Spadeyache/RoboCupJunior_RescueLine/README.md

/CanMV... for k230d zero development

/k230dev-yolo...enviroment to train a yolov8n model and convert to a .kmodel for k230

/teensydev... teensy4.1 developments

/xiaoesp32dev...all developments for xiao

/Electronics... all electronics development - We use EasyEDA as our main ecad software
