Spadeyache/RoboCupJunior_RescueLine/(list of files, drawings)

Other design files:
Electronics/archiveKicad/ProPrj_Final Main_2026-01-12.epro
Electronics/easyEDA/1-12.eprj
Electronics/easyEDA/Final Main.eprj
Electronics/easyEDA/powermanagmen.eprj
Electronics/easyEDA/XIAO Board.eprj
Electronics/Main.eprj
Electronics/ProPrj_Final Main_2026-01-12.epro
Electronics/XIAO ESP32C3 Adapter board copy.eprj
