Spadeyache/RoboCupJunior_RescueLine/Electronics/archiveKicad/main/main.kicad_pcb

## KiCad design Electronics/archiveKicad/main/main.kicad_pcb (2026-01-02, an earlier design)

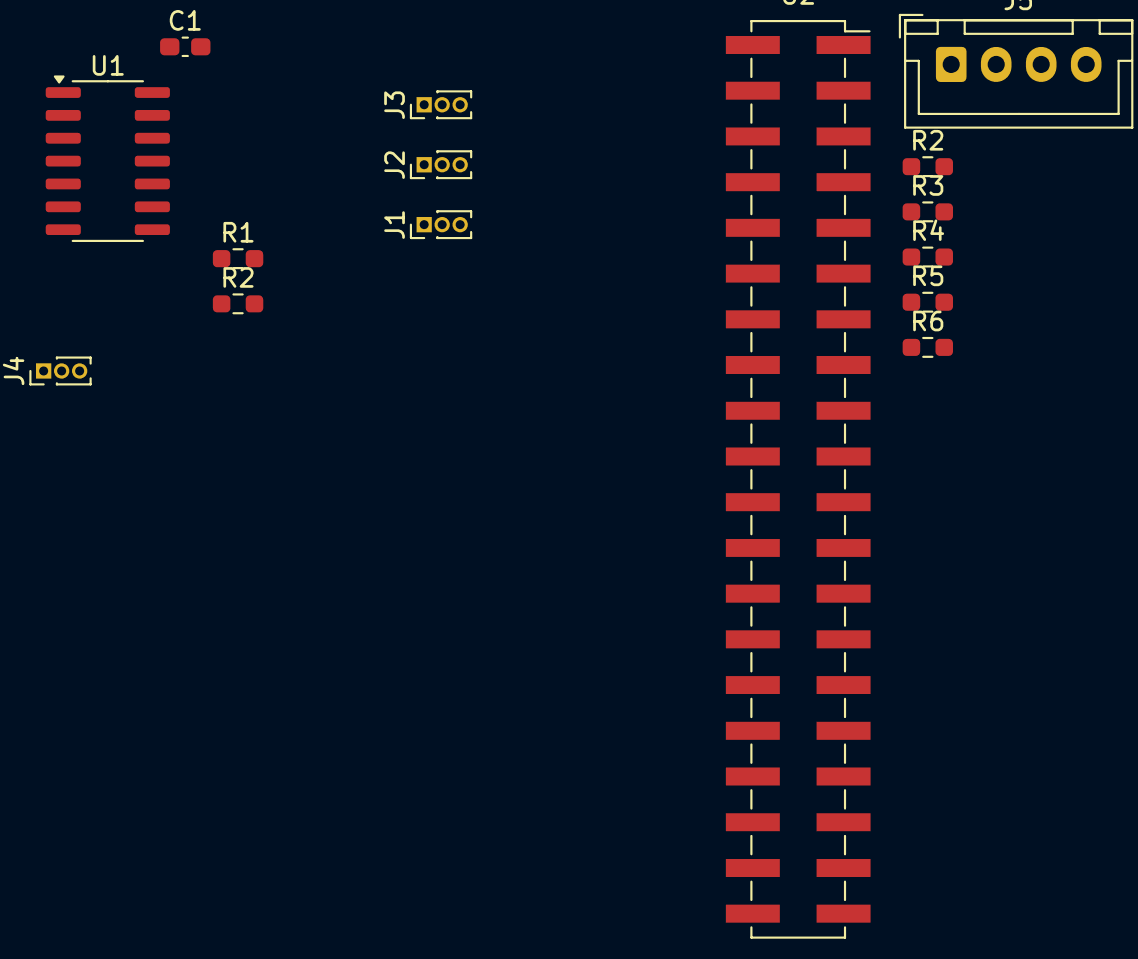
[picture p2: board main.kicad_pcb from above]

Board: 2 copper layers, 15 parts (0 on the bottom side), 8 nets, no tracks yet.

Parts:
C1: 0.1uF; C_0603_1608Metric_Pad1.08x0.95mm_HandSolder
J1: STS3032; PinHeader_1x03_P1.00mm_Vertical
J2: KRS3301; PinHeader_1x03_P1.00mm_Vertical
J3: HS45HB-0; PinHeader_1x03_P1.00mm_Vertical
J4: HS45HB-1; PinHeader_1x03_P1.00mm_Vertical
J5: IMU MPU6050; JST_XH_B4B-XH-A_1x04_P2.50mm_Vertical
R1, R2: 10k; R_0603_1608Metric_Pad0.98x0.95mm_HandSolder
R2#2, R3, R4, R5, R6: 10k?; R_0603_1608Metric_Pad0.98x0.95mm_HandSolder
U1: 74LS126; SOIC-14_3.9x8.7mm_P1.27mm
U2: K230D; PinSocket_2x20_P2.54mm_Vertical_SMD

Connections:
+5V: C1.2, J3.1, J4.1, U1.4, U1.10, U1.13, U1.14 (VCC)
+6.6V: J1.1, J2.1
GND: C1.1, J1.3, J2.3, J3.3, J4.3, J5.1, R1.1, U1.7 (GND)
HS45HB-0 signal: J3.2, U1.8
HS45HB-1 signal: J4.2, U1.11
KRS3301 signal: J2.2, U1.6
STS3032 signal: J1.2, U1.3
Teensy 2?: R1.2, U1.1
