Spadeyache/RoboCupJunior_RescueLine/Electronics/archiveKicad/Main (2).kicad_pcb

## KiCad design Electronics/archiveKicad/Main (2).kicad_pcb (2025-11-23, an earlier design)

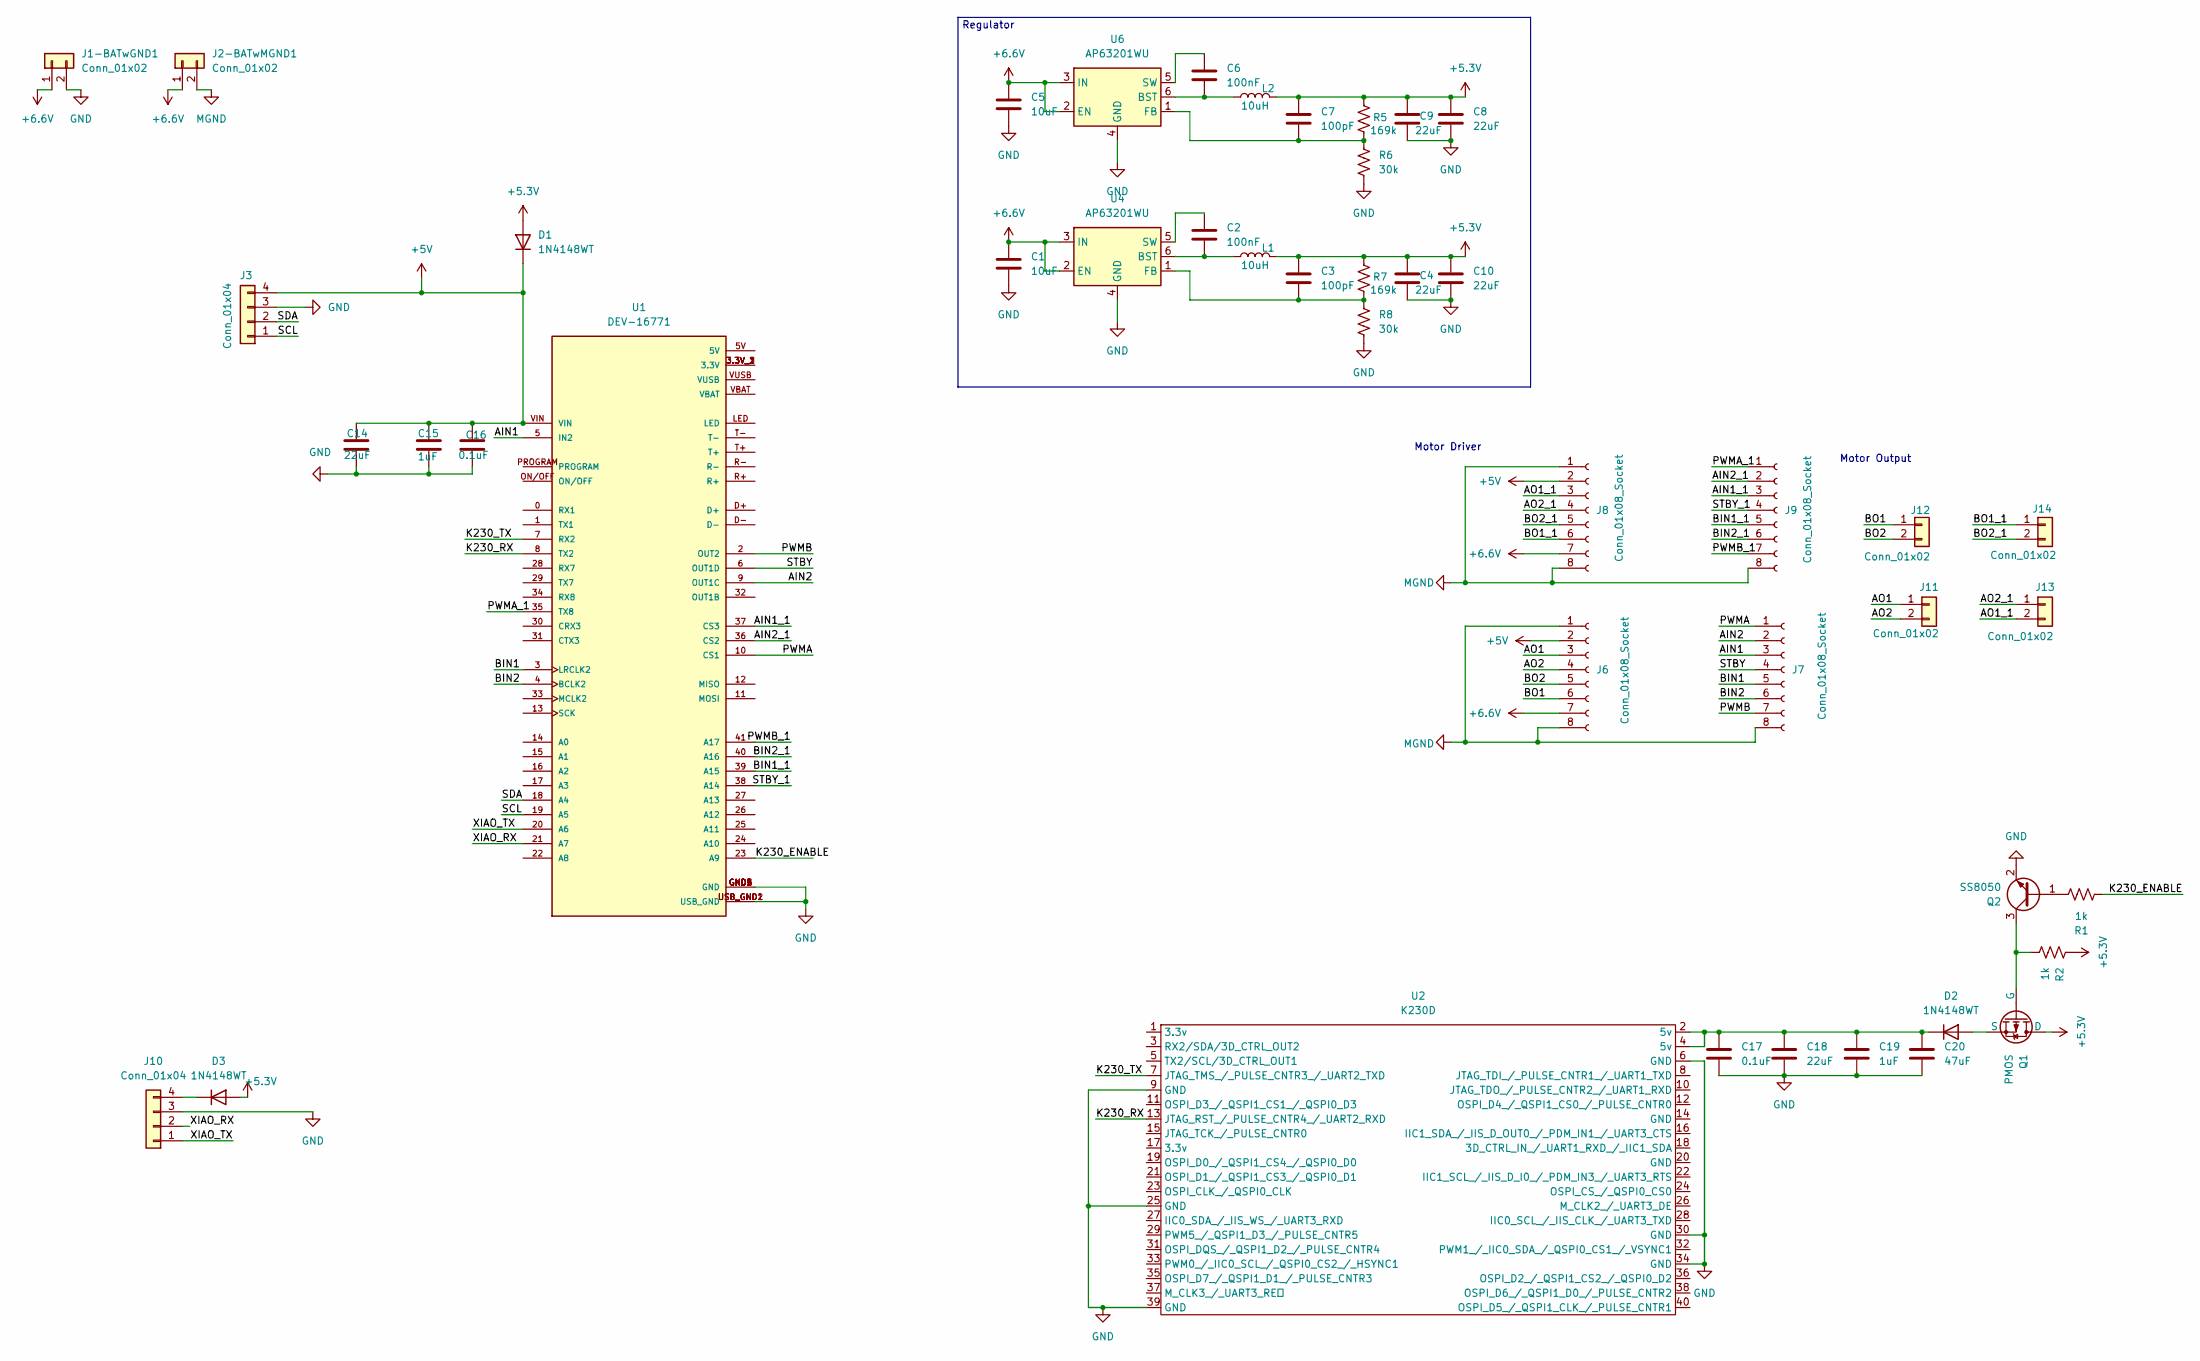
[picture p3: schematic Main (2).kicad_sch]

Parts:
C1, C5: 10uF; C_0603_1608Metric
C2, C6: 100nF; C_0603_1608Metric
C3, C7: 100pF; C_0603_1608Metric
C4, C8, C9, C10, C14, C18: 22uF; C_0603_1608Metric
C15, C19: 1uF; C_0603_1608Metric
C16, C17: 0.1uF; C_0603_1608Metric
C20: 47uF; C_0603_1608Metric
D1, D2, D3: 1N4148WT; D_SOD-523
J1-BATwGND1, J2-BATwMGND1, J11, J12, J13, J14: Conn_01x02; TE_440054-2_1x02_P2.00mm_Vertical
J3, J10: Conn_01x04; JST_XH_B4B-XH-A_1x04_P2.50mm_Vertical
J6, J7, J8, J9: Conn_01x08_Socket; PinHeader_1x08_P2.54mm_Vertical
L1, L2: 10uH; L_0603_1608Metric
Q1: PMOS; SOT-23
Q2: SS8050; SOT-23
R1, R2: 1k; R_0603_1608Metric
R5, R7: 169k; R_0603_1608Metric
R6, R8: 30k; R_0603_1608Metric
U1: DEV-16771; Teensy4.1; PARTREV 4.1
U2: K230D; PinSocket_2x20_P2.54mm_Vertical_SMD
U4, U6: AP63201WU; TSOT-23-6

Connections:
+5.3V: C3.1, C4.1, C7.1, C8.1, C9.1, C10.1, D1.2 (A), D3.2 (A), L1.2, L2.2, Q1.1 (D), R2.1, R5.1, R7.1; also elsewhere on the board
+5V: C14.1, C15.1, C16.1, D1.1 (K), J3.4, J6.2, J8.2, U1.VIN
+6.6V: C1.1, C5.1, J1-BATwGND1.1, J2-BATwMGND1.1, J6.7, J8.7, U4.2 (EN), U4.3 (IN), U6.2 (EN), U6.3 (IN); also elsewhere on the board
/AIN1: J7.3, U1.5 (IN2)
/AIN1_1: J9.3, U1.37 (CS3)
/AIN2: J7.2, U1.9 (OUT1C)
/AIN2_1: J9.2, U1.36 (CS2)
/AO1: J6.3, J11.1
/AO1_1: J8.3, J13.2
/AO2: J6.4, J11.2
/AO2_1: J8.4, J13.1
/BIN1: J7.5, U1.3 (LRCLK2)
/BIN1_1: J9.5, U1.39 (A15)
/BIN2: J7.6, U1.4 (BCLK2)
/BIN2_1: J9.6, U1.40 (A16)
/BO1: J6.6, J12.1
/BO1_1: J8.6, J14.1
/BO2: J6.5, J12.2
/BO2_1: J8.5, J14.2
/K230_ENABLE: R1.1, U1.23 (A9)
/K230_RX: U1.8 (TX2), U2.13 (JTAG_RST_/_PULSE_CNTR4_/_UART2_RXD)
/K230_TX: U1.7 (RX2), U2.7 (JTAG_TMS_/_PULSE_CNTR3_/_UART2_TXD)
/PWMA: J7.1, U1.10 (CS1)
/PWMA_1: J9.1, U1.35 (TX8)
/PWMB: J7.7, U1.2 (OUT2)
/PWMB_1: J9.7, U1.41 (A17)
/SCL: J3.1, U1.19 (A5)
/SDA: J3.2, U1.18 (A4)
/STBY: J7.4, U1.6 (OUT1D)
/STBY_1: J9.4, U1.38 (A14)
/XIAO_RX: J10.2, U1.21 (A7)
/XIAO_TX: J10.1, U1.20 (A6)
GND: C1.2, C4.2, C5.2, C8.2, C9.2, C10.2, C14.2, C15.2, C16.2, C17.2, C18.2, C19.2, C20.2, J1-BATwGND1.2, J3.3, J10.3, Q2.2 (E), R6.2, R8.2, U1.GND1 (GND), U1.GND2 (GND), U1.GND3 (GND), U1.GND4 (GND), U1.GND5 (GND), U1.USB_GND1 (USB_GND), U1.USB_GND2 (USB_GND), U2.6 (GND), U2.9 (GND), U2.25 (GND), U2.30 (GND), U2.34 (GND), U2.39 (GND), U4.4 (GND), U6.4 (GND); also elsewhere on the board
MGND: J2-BATwMGND1.2, J6.1, J6.8, J7.8, J8.1, J8.8, J9.8; also elsewhere on the board
unnamed: D2.2 (A), Q1.3 (S)
unnamed: C17.1, C18.1, C19.1, C20.1, D2.1 (K), U2.2 (5v), U2.4 (5v)
unnamed: D3.1 (K), J10.4
unnamed: Q1.2 (G), Q2.3 (C), R2.2
unnamed: Q2.1 (B), R1.2
unnamed: U1.3.3V_1 (3.3V), U1.3.3V_2 (3.3V), U1.3.3V_3 (3.3V)
unnamed: C2.2, L1.1, U4.6 (BST)
unnamed: C3.2, R7.2, R8.1, U4.1 (FB)
unnamed: C2.1, U4.5 (SW)
unnamed: C6.2, L2.1, U6.6 (BST)
unnamed: C7.2, R5.2, R6.1, U6.1 (FB)
unnamed: C6.1, U6.5 (SW)

Notes on the sheet:
Regulator
Motor Output
Motor Driver

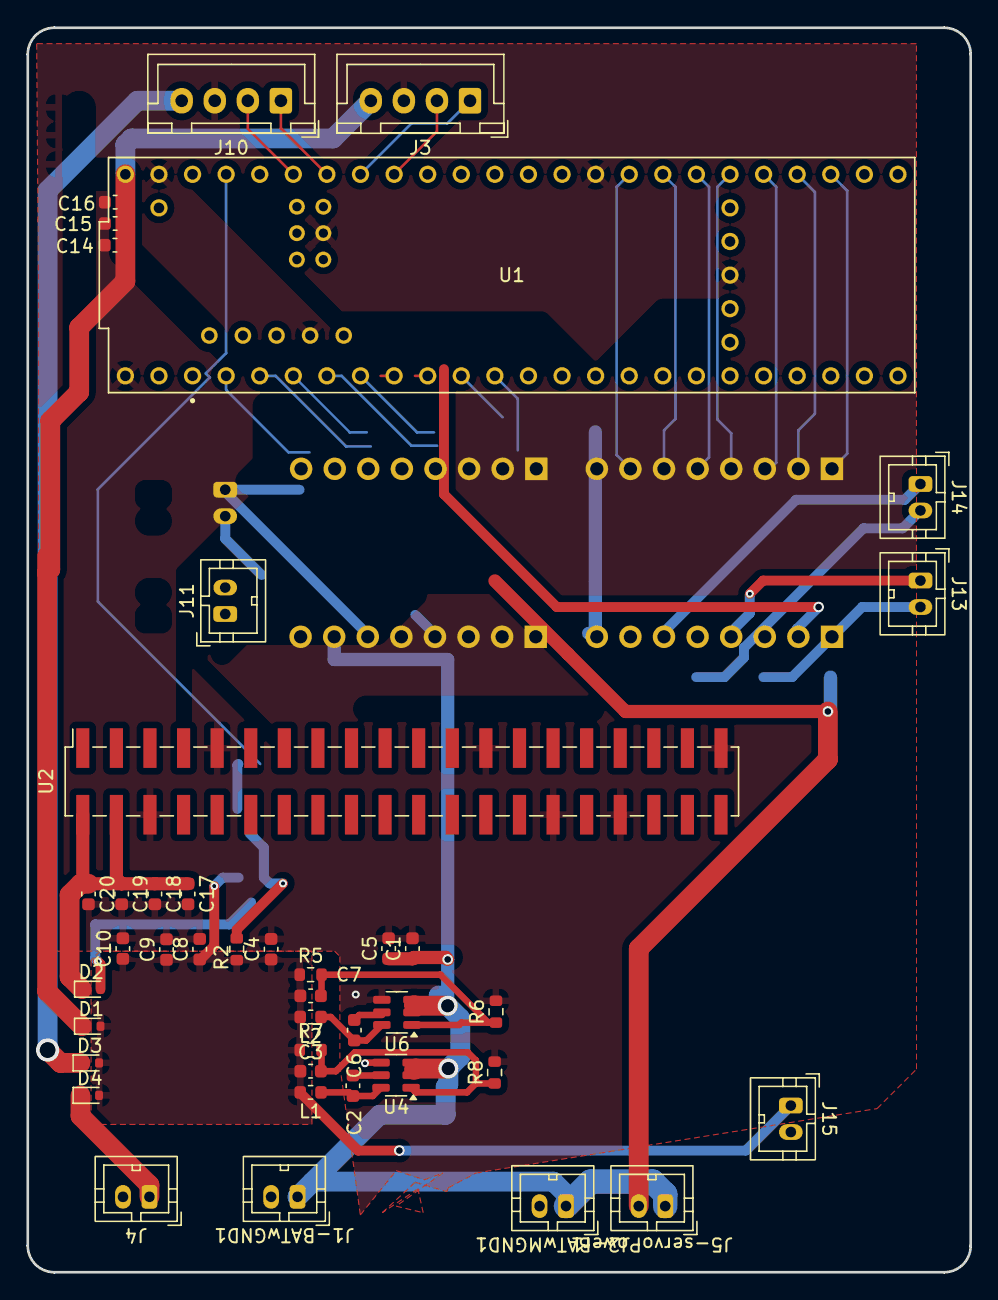
[picture p4: board Main (2).kicad_pcb from above]

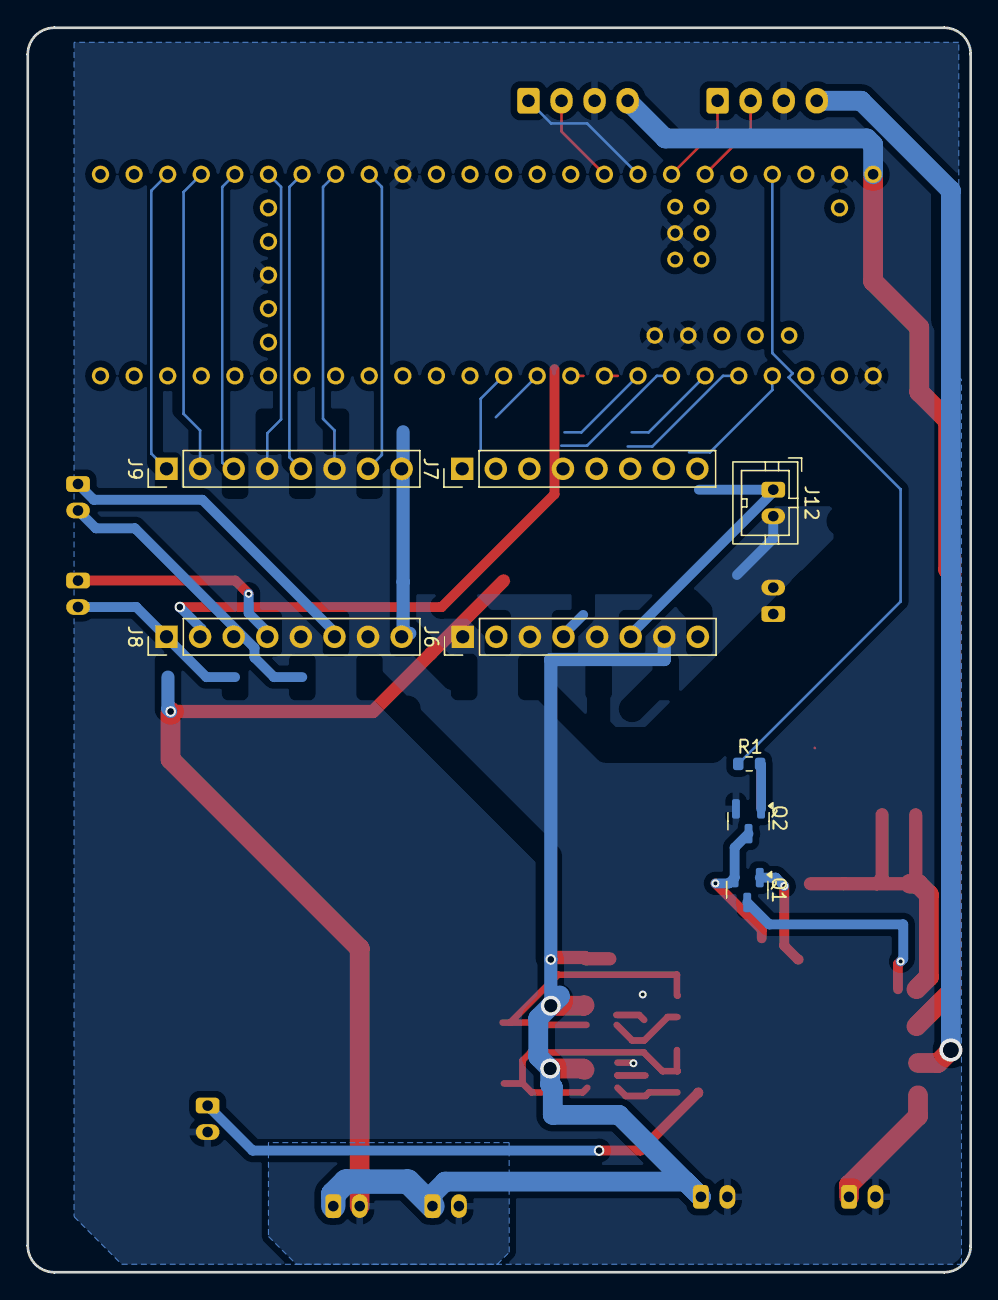
[picture p5: board Main (2).kicad_pcb from below]

Board: 2 copper layers, 71.3 x 94.1 mm, 50 parts (8 on the bottom side), 47 nets.

Other parts of the board:
D4: 1N4148WT; D_SOD-523
J4, J5-servoPower1, J15: Conn_01x02; TE_440054-2_1x02_P2.00mm_Vertical

Their connections:
+5.3V: D4.2 (A), J15.1; also elsewhere on the board
+6.6V: J5-servoPower1.1; also elsewhere on the board
GND: J4.2, J15.2; also elsewhere on the board
MGND: J5-servoPower1.2; also elsewhere on the board
unnamed: D4.1 (K), J4.1
