Spadeyache/RoboCupJunior_RescueLine/Electronics/archiveKicad/Power_Set.kicad_pcb

## KiCad design Electronics/archiveKicad/Power_Set.kicad_pcb (2025-12-26, an earlier design)

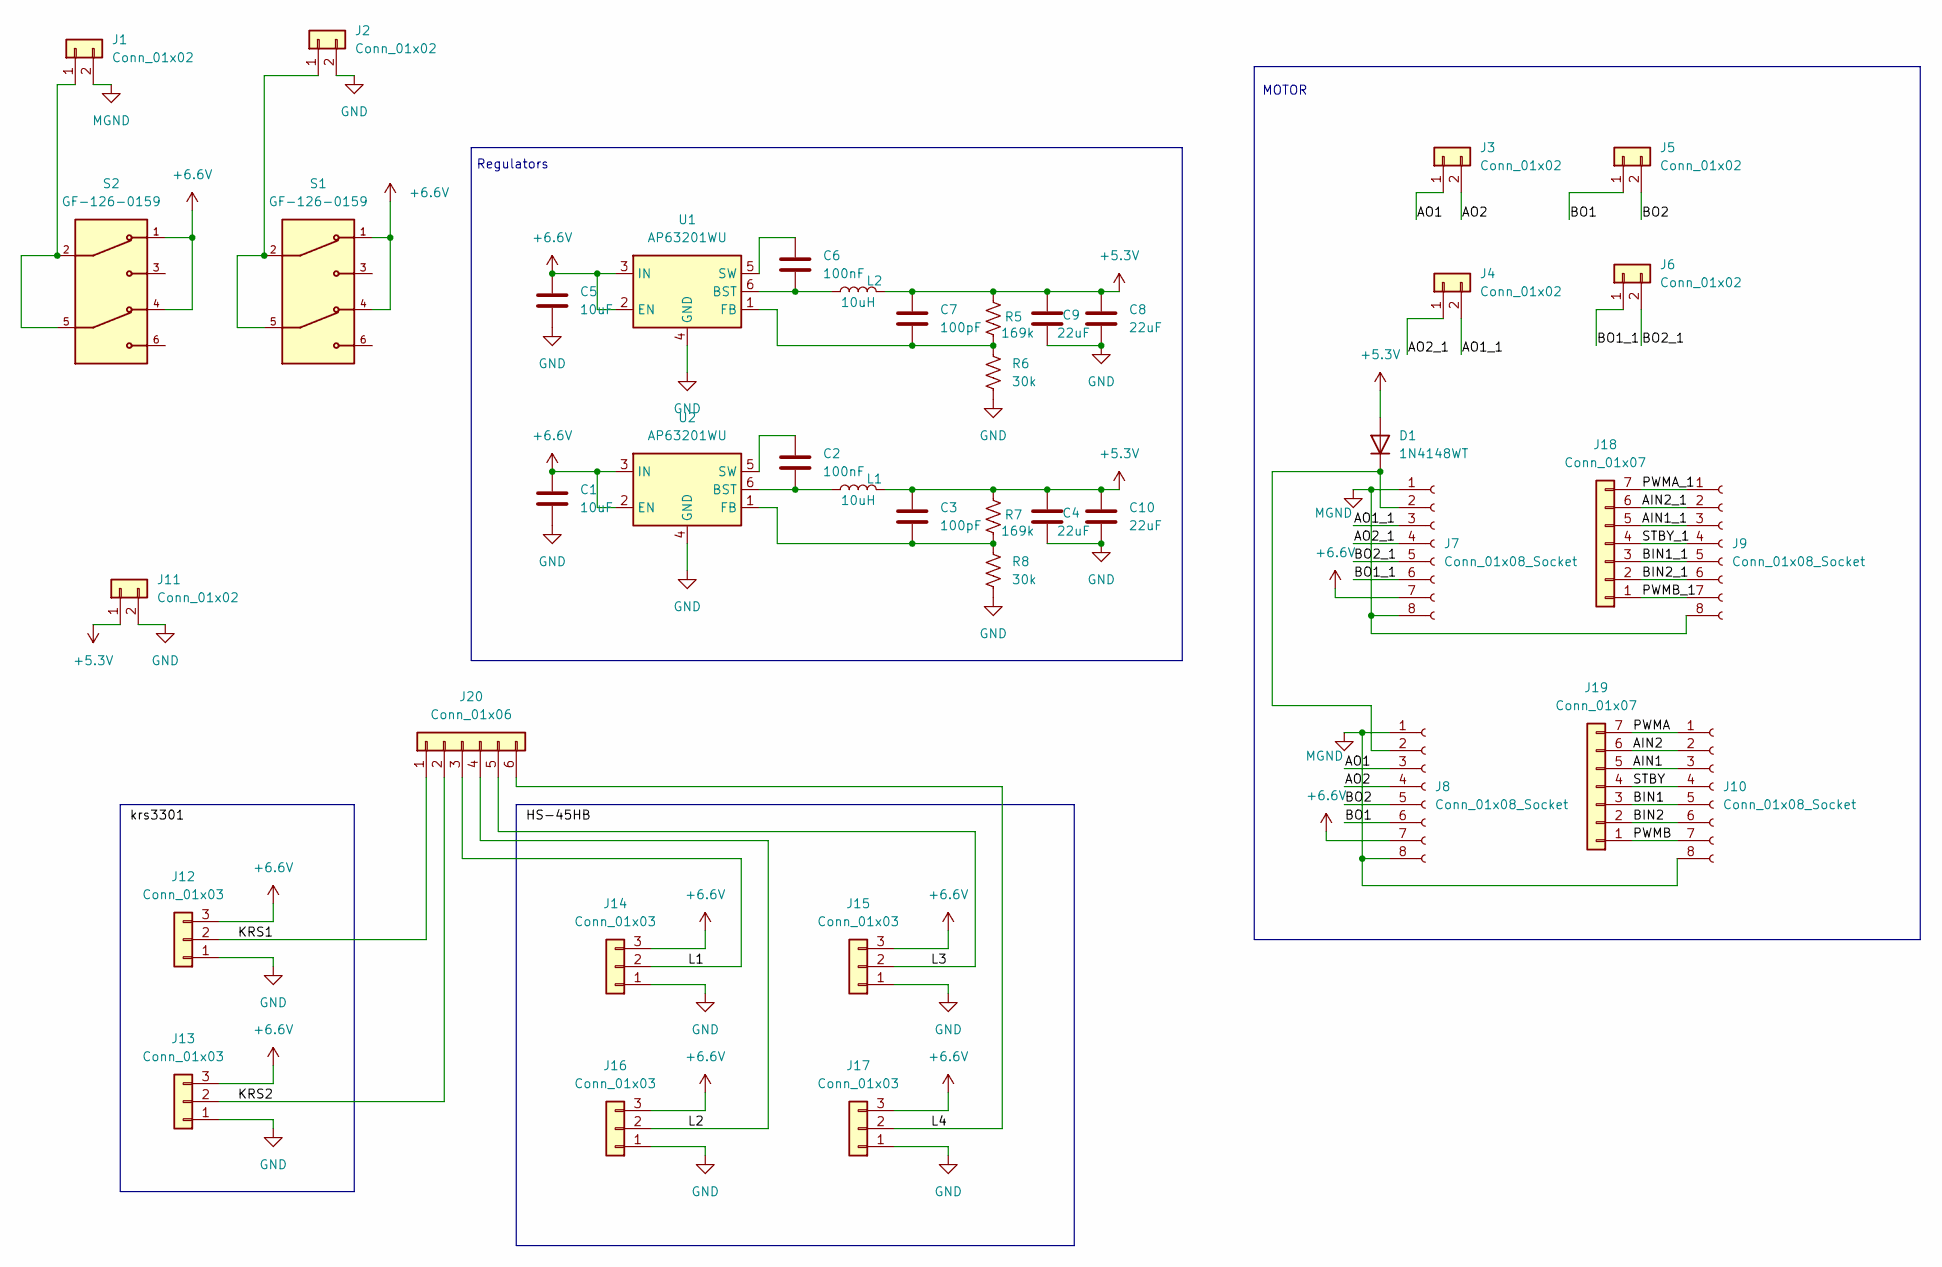
[picture p6: schematic Power_Set.kicad_sch]

Parts:
C1, C5: 10uF; C_0603_1608Metric
C2, C6: 100nF; C_0603_1608Metric
C3, C7: 100pF; C_0603_1608Metric
C4, C8, C9, C10: 22uF; C_0603_1608Metric
D1: 1N4148WT; D_SOD-523
J1, J2, J3, J4, J5, J6, J11: Conn_01x02; Molex_KK-396_A-41791-0002_1x02_P3.96mm_Vertical
J7, J8, J9, J10: Conn_01x08_Socket; PinHeader_1x08_P2.54mm_Vertical
J12, J13, J14, J15, J16, J17: Conn_01x03; JST_EH_B3B-EH-A_1x03_P2.50mm_Vertical
J18, J19: Conn_01x07; JST_EH_B7B-EH-A_1x07_P2.50mm_Vertical
J20: Conn_01x06; JST_EH_B6B-EH-A_1x06_P2.50mm_Vertical
L1, L2: 10uH; L_1210_3225Metric
R5, R7: 169k; R_0603_1608Metric
R6, R8: 30k; R_0603_1608Metric
S1, S2: GF-126-0159; SW_GF-126-0159
U1, U2: AP63201WU; TSOT-23-6

Connections:
+5.3V: C3.1, C4.1, C7.1, C8.1, C9.1, C10.1, D1.2 (A), J11.1, L1.2, L2.2, R5.1, R7.1
+6.6V: C1.1, C5.1, J7.7, J8.7, J12.3, J13.3, J14.3, J15.3, J16.3, J17.3, S1.1, S1.4, S2.1, S2.4, U1.2 (EN), U1.3 (IN), U2.2 (EN), U2.3 (IN)
/AIN1: J10.3, J19.5
/AIN1_1: J9.3, J18.5
/AIN2: J10.2, J19.6
/AIN2_1: J9.2, J18.6
/AO1: J3.1, J8.3
/AO1_1: J4.2, J7.3
/AO2: J3.2, J8.4
/AO2_1: J4.1, J7.4
/BIN1: J10.5, J19.3
/BIN1_1: J9.5, J18.3
/BIN2: J10.6, J19.2
/BIN2_1: J9.6, J18.2
/BO1: J5.1, J8.6
/BO1_1: J6.1, J7.6
/BO2: J5.2, J8.5
/BO2_1: J6.2, J7.5
/KRS1: J12.2, J20.1
/KRS2: J13.2, J20.2
/L1: J14.2, J20.3
/L2: J16.2, J20.4
/L3: J15.2, J20.5
/L4: J17.2, J20.6
/PWMA: J10.1, J19.7
/PWMA_1: J9.1, J18.7
/PWMB: J10.7, J19.1
/PWMB_1: J9.7, J18.1
/STBY: J10.4, J19.4
/STBY_1: J9.4, J18.4
GND: C1.2, C4.2, C5.2, C8.2, C9.2, C10.2, J2.2, J11.2, J12.1, J13.1, J14.1, J15.1, J16.1, J17.1, R6.2, R8.2, U1.4 (GND), U2.4 (GND)
MGND: J1.2, J7.1, J7.8, J8.1, J8.8, J9.8, J10.8
unnamed: D1.1 (K), J7.2, J8.2
unnamed: J1.1, S2.2, S2.5
unnamed: J2.1, S1.2, S1.5
unnamed: C6.2, L2.1, U1.6 (BST)
unnamed: C7.2, R5.2, R6.1, U1.1 (FB)
unnamed: C6.1, U1.5 (SW)
unnamed: C2.2, L1.1, U2.6 (BST)
unnamed: C3.2, R7.2, R8.1, U2.1 (FB)
unnamed: C2.1, U2.5 (SW)

Notes on the sheet:
Regulators
MOTOR

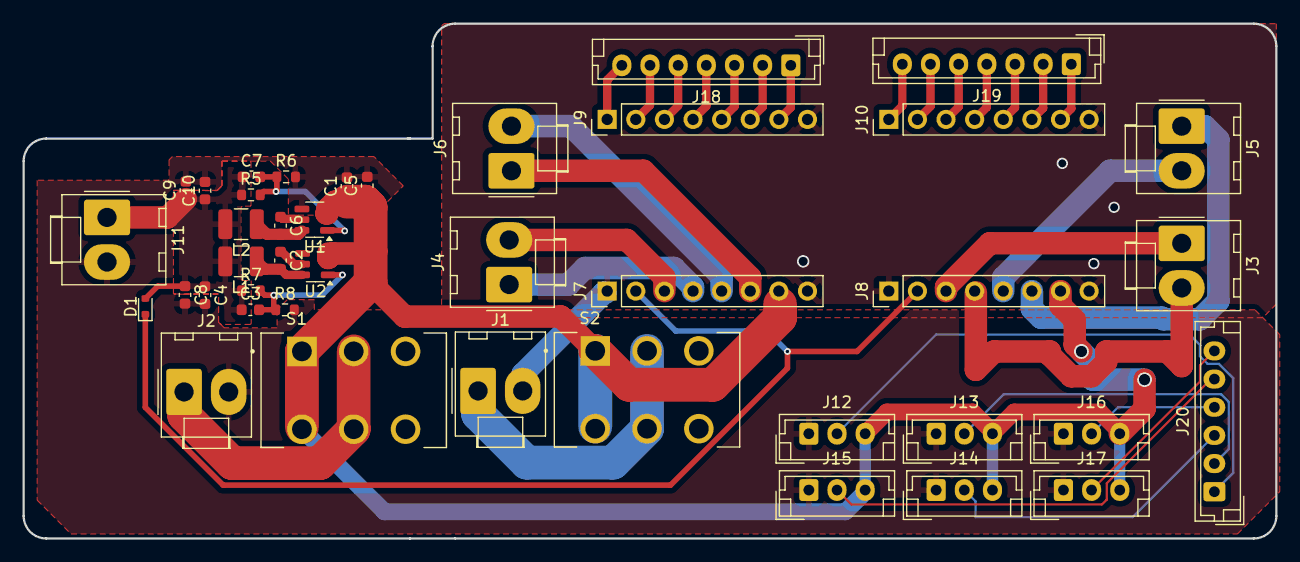
[picture p7: board Power_Set.kicad_pcb from above]

Board: 2 copper layers, 111.2 x 45.7 mm, 41 parts (0 on the bottom side), 41 nets.
