Spadeyache/RoboCupJunior_RescueLine/Electronics/archiveKicad/Logic_Set.kicad_pcb

## KiCad design Electronics/archiveKicad/Logic_Set.kicad_pcb (2025-12-26, an earlier design)

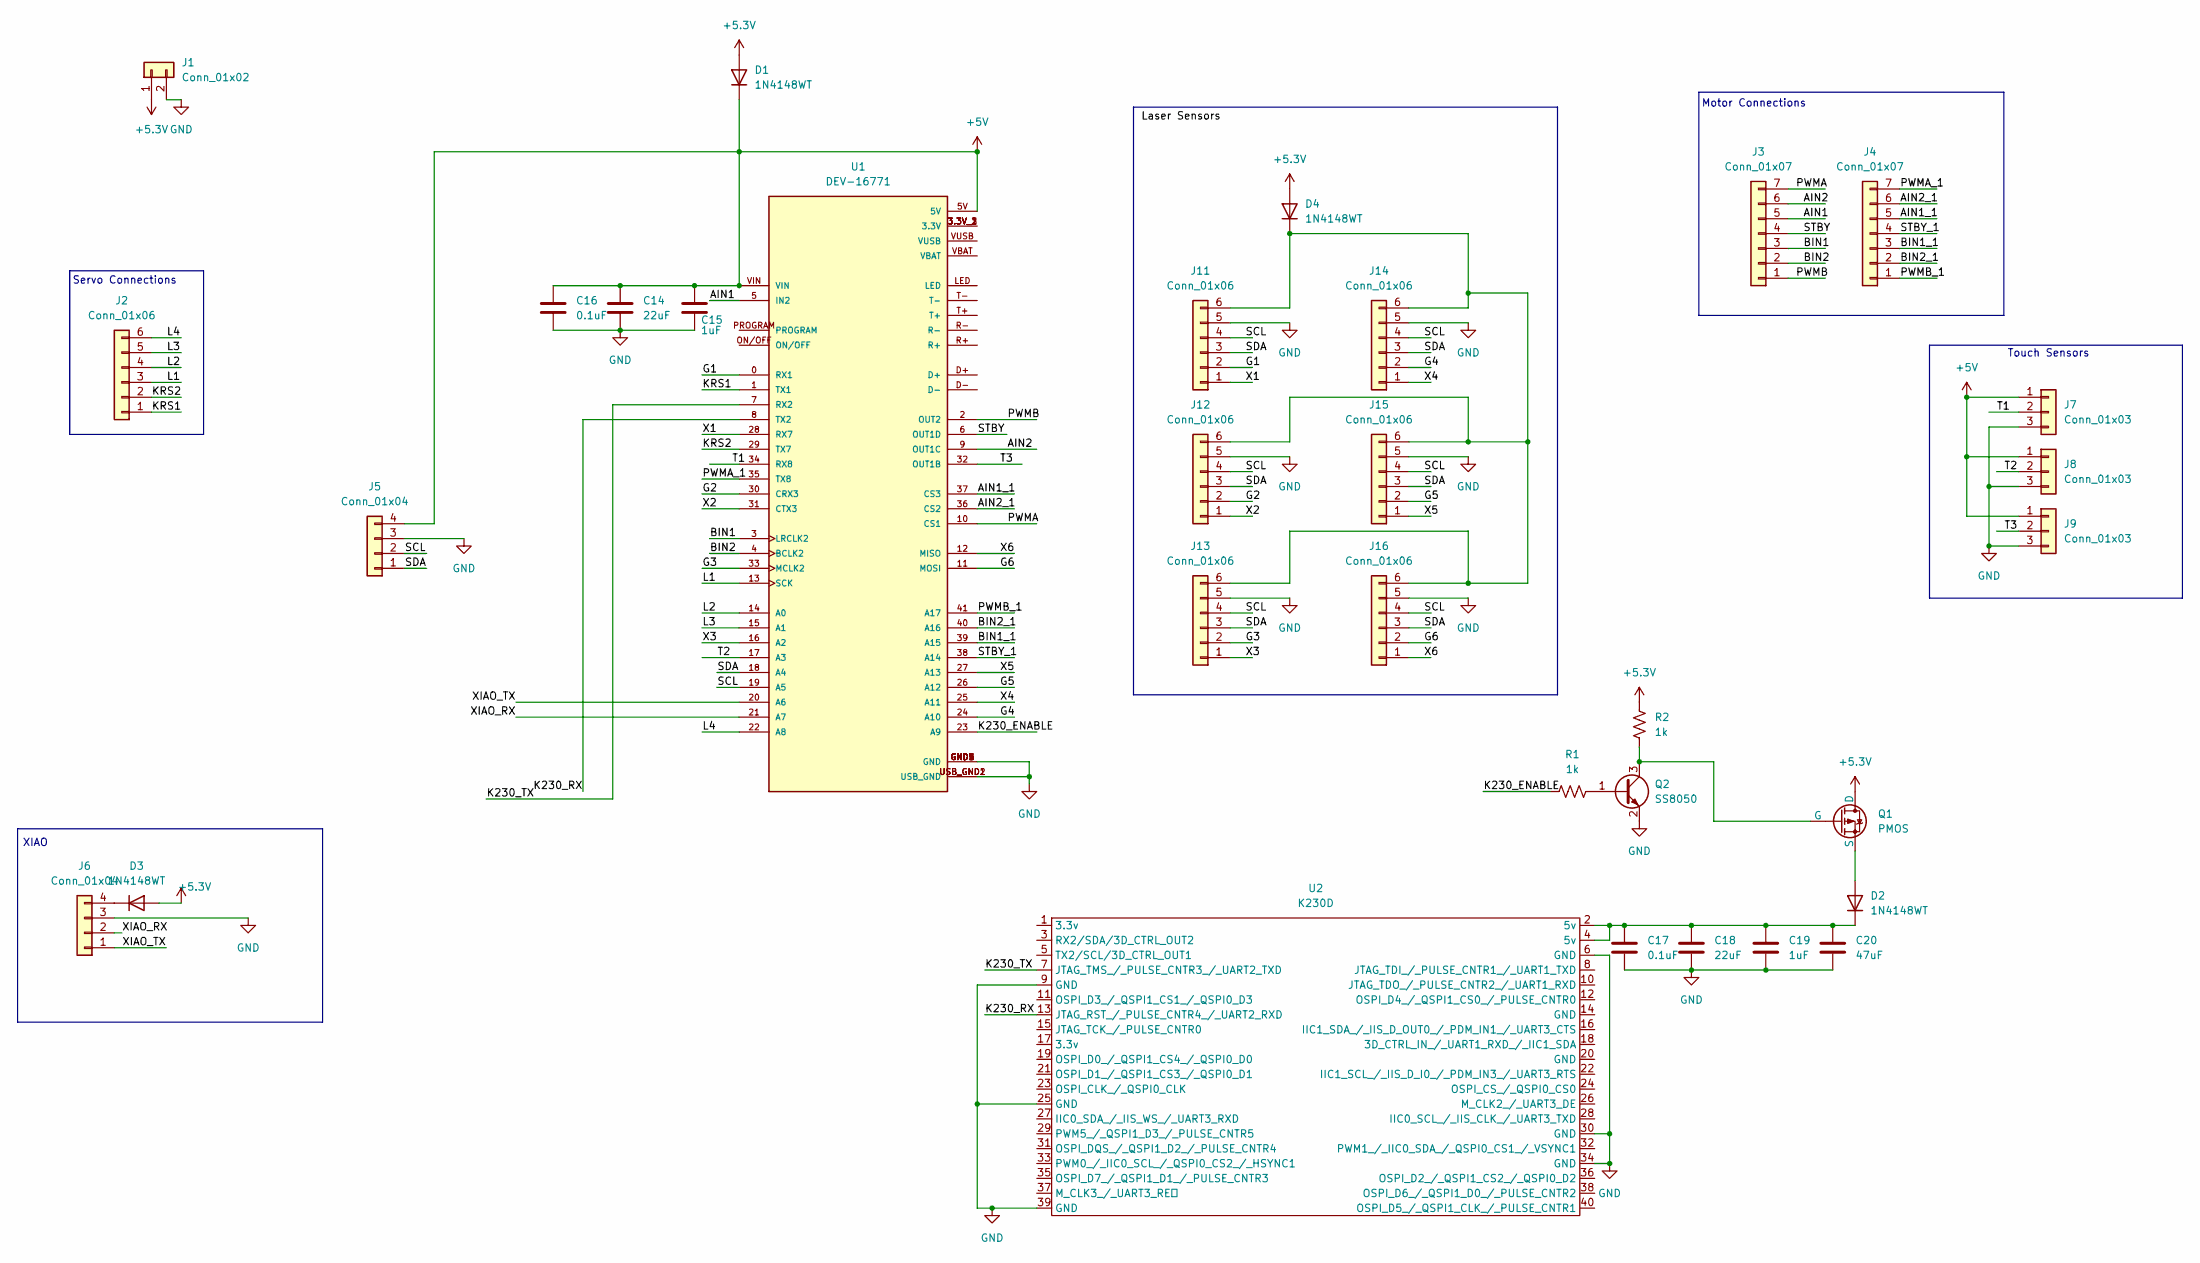
[picture p8: schematic Logic_Set.kicad_sch]

Parts:
C14, C18: 22uF; C_0603_1608Metric
C15, C19: 1uF; C_0603_1608Metric
C16, C17: 0.1uF; C_0603_1608Metric
C20: 47uF; C_0603_1608Metric
D1, D2, D3, D4: 1N4148WT; D_SOD-523
J1: Conn_01x02; Molex_KK-396_5273-02A_1x02_P3.96mm_Vertical
J2, J11, J12, J13, J14, J15, J16: Conn_01x06; JST_EH_B6B-EH-A_1x06_P2.50mm_Vertical
J3, J4: Conn_01x07; JST_EH_B7B-EH-A_1x07_P2.50mm_Vertical
J5, J6: Conn_01x04; JST_EH_B4B-EH-A_1x04_P2.50mm_Vertical
J7, J8, J9: Conn_01x03; JST_EH_B3B-EH-A_1x03_P2.50mm_Vertical
Q1: PMOS; SOT-23
Q2: SS8050; SOT-23
R1, R2: 1k; R_0603_1608Metric
U1: DEV-16771; Teensy4.1; PARTREV 4.1
U2: K230D; PinSocket_2x20_P2.54mm_Vertical_SMD

Connections:
+5.3V: D1.2 (A), D3.2 (A), D4.2 (A), J1.1, Q1.1 (D), R2.1
+5V: C14.1, C15.1, C16.1, D1.1 (K), J5.4, J7.1, J8.1, J9.1, U1.5V, U1.VIN
/AIN1: J3.5, U1.5 (IN2)
/AIN1_1: J4.5, U1.37 (CS3)
/AIN2: J3.6, U1.9 (OUT1C)
/AIN2_1: J4.6, U1.36 (CS2)
/BIN1: J3.3, U1.3 (LRCLK2)
/BIN1_1: J4.3, U1.39 (A15)
/BIN2: J3.2, U1.4 (BCLK2)
/BIN2_1: J4.2, U1.40 (A16)
/G1: J11.2, U1.0 (RX1)
/G2: J12.2, U1.30 (CRX3)
/G3: J13.2, U1.33 (MCLK2)
/G4: J14.2, U1.24 (A10)
/G5: J15.2, U1.26 (A12)
/G6: J16.2, U1.11 (MOSI)
/K230_ENABLE: R1.1, U1.23 (A9)
/K230_RX: U1.8 (TX2), U2.13 (JTAG_RST_/_PULSE_CNTR4_/_UART2_RXD)
/K230_TX: U1.7 (RX2), U2.7 (JTAG_TMS_/_PULSE_CNTR3_/_UART2_TXD)
/KRS1: J2.1, U1.1 (TX1)
/KRS2: J2.2, U1.29 (TX7)
/L1: J2.3, U1.13 (SCK)
/L2: J2.4, U1.14 (A0)
/L3: J2.5, U1.15 (A1)
/L4: J2.6, U1.22 (A8)
/PWMA: J3.7, U1.10 (CS1)
/PWMA_1: J4.7, U1.35 (TX8)
/PWMB: J3.1, U1.2 (OUT2)
/PWMB_1: J4.1, U1.41 (A17)
/SCL: J5.2, J11.4, J12.4, J13.4, J14.4, J15.4, J16.4, U1.19 (A5)
/SDA: J5.1, J11.3, J12.3, J13.3, J14.3, J15.3, J16.3, U1.18 (A4)
/STBY: J3.4, U1.6 (OUT1D)
/STBY_1: J4.4, U1.38 (A14)
/T1: J7.2, U1.34 (RX8)
/T2: J8.2, U1.17 (A3)
/T3: J9.2, U1.32 (OUT1B)
/X1: J11.1, U1.28 (RX7)
/X2: J12.1, U1.31 (CTX3)
/X3: J13.1, U1.16 (A2)
/X4: J14.1, U1.25 (A11)
/X5: J15.1, U1.27 (A13)
/X6: J16.1, U1.12 (MISO)
/XIAO_RX: J6.2, U1.21 (A7)
/XIAO_TX: J6.1, U1.20 (A6)
GND: C14.2, C15.2, C16.2, C17.2, C18.2, C19.2, C20.2, J1.2, J5.3, J6.3, J7.3, J8.3, J9.3, J11.5, J12.5, J13.5, J14.5, J15.5, J16.5, Q2.2 (E), U1.GND1 (GND), U1.GND2 (GND), U1.GND3 (GND), U1.GND4 (GND), U1.GND5 (GND), U1.USB_GND1 (USB_GND), U1.USB_GND2 (USB_GND), U2.6 (GND), U2.9 (GND), U2.25 (GND), U2.30 (GND), U2.34 (GND), U2.39 (GND)
unnamed: D2.2 (A), Q1.3 (S)
unnamed: C17.1, C18.1, C19.1, C20.1, D2.1 (K), U2.2 (5v), U2.4 (5v)
unnamed: D3.1 (K), J6.4
unnamed: D4.1 (K), J11.6, J12.6, J13.6, J14.6, J15.6, J16.6
unnamed: Q1.2 (G), Q2.3 (C), R2.2
unnamed: Q2.1 (B), R1.2
unnamed: U1.3.3V_1 (3.3V), U1.3.3V_2 (3.3V), U1.3.3V_3 (3.3V)

Notes on the sheet:
Motor Connections
Servo Connections
XIAO
Touch Sensors

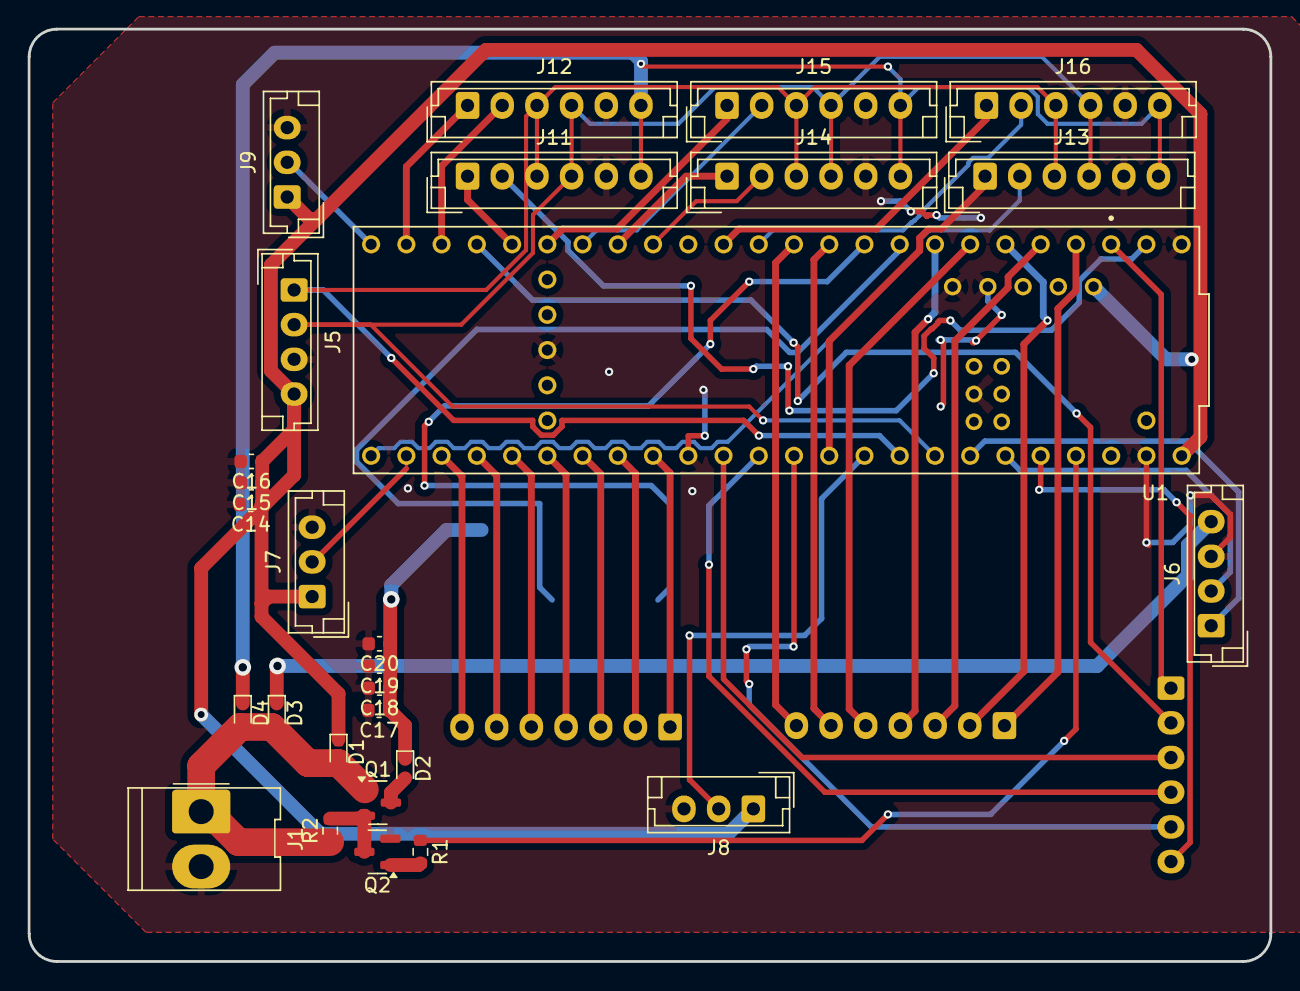
[picture p9: board Logic_Set.kicad_pcb from above]

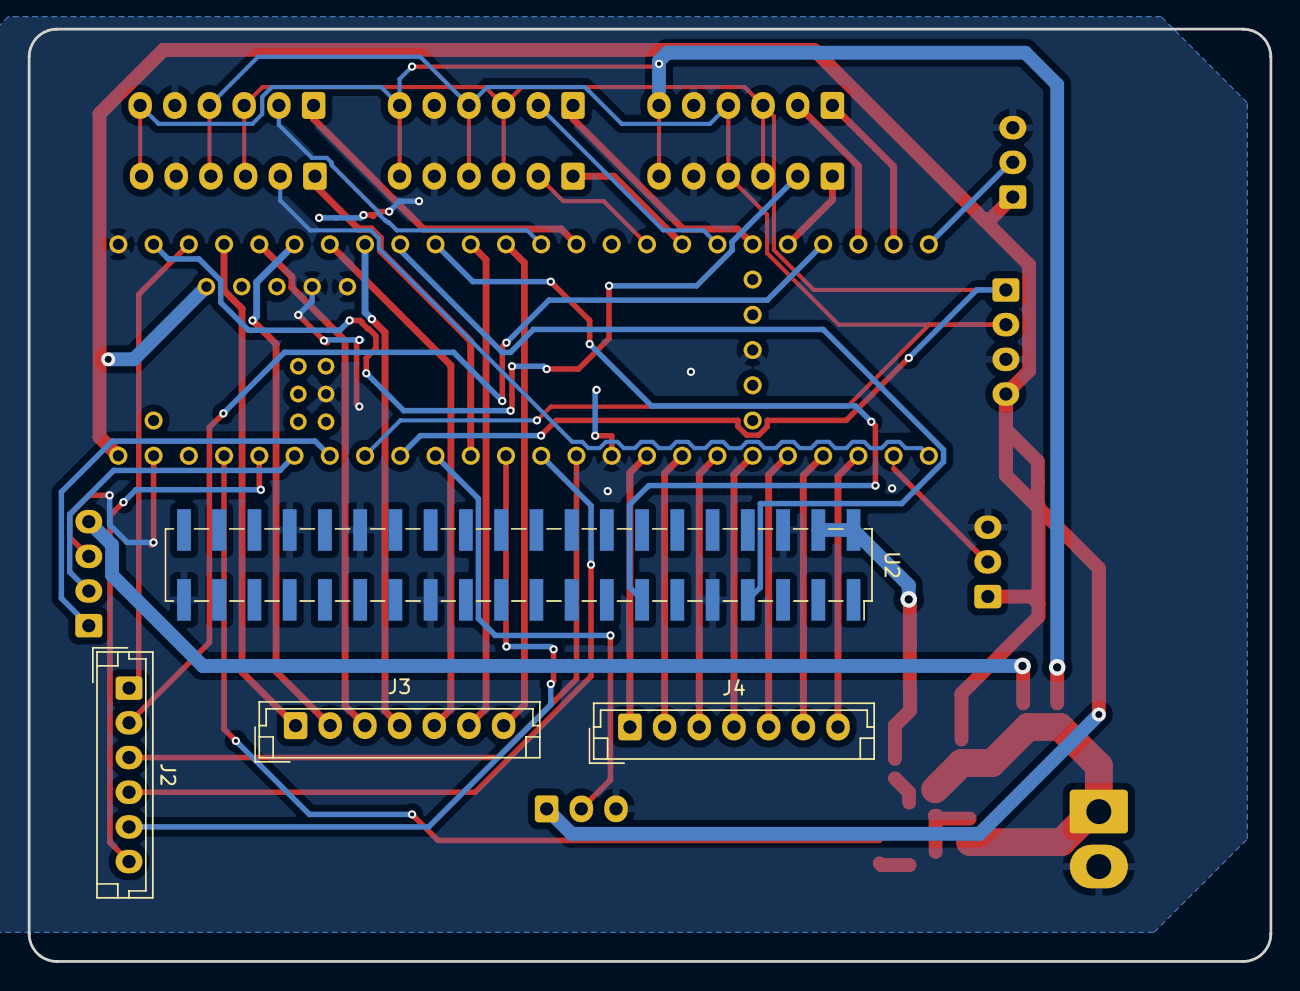
[picture p10: board Logic_Set.kicad_pcb from below]

Board: 2 copper layers, 89.5 x 67.2 mm, 32 parts (4 on the bottom side), 52 nets.
