Spadeyache/RoboCupJunior_RescueLine/Battery Management.kicad_pcb

## KiCad design Electronics/archiveKicad/Battery Management.kicad_pcb (2025-10-29, an earlier design)

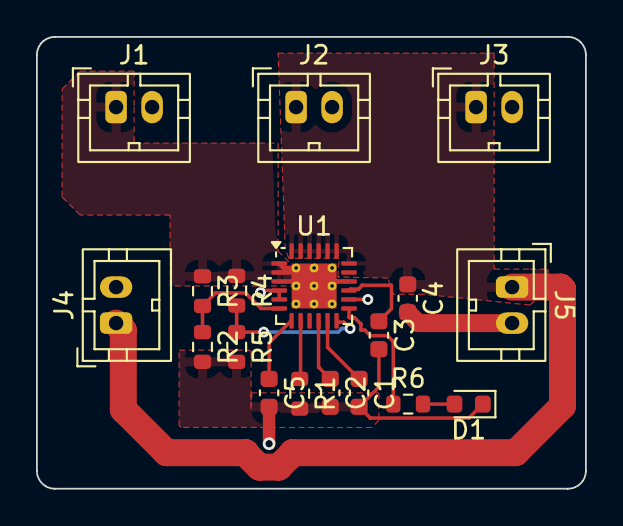
[picture p11: board Battery Management.kicad_pcb from above]

Board: 2 copper layers, 30.5 x 25.1 mm, 18 parts (0 on the bottom side), 12 nets.

Parts:
C1: 330pF; C_0603_1608Metric
C2: 128pF; C_0603_1608Metric
C3: 2.2nF; C_0603_1608Metric
C4: 470nF; C_0603_1608Metric
C5: 22nF; C_0603_1608Metric
D1: LED; D_0603_1608Metric
J1, J2, J3, J4, J5: Conn_01x02; TE_440054-2_1x02_P2.00mm_Vertical
R1: 148; R_0603_1608Metric
R2: 225k; R_0603_1608Metric
R3, R4: 1M; R_0603_1608Metric
R5: 2k; R_0603_1608Metric
R6: 10K; R_0603_1608Metric
U1: TSP25983; VQFN-24-1EP_4x4mm_P0.5mm_EP2.5x2.5mm_ThermalVias

Connections:
+6.6V: C4.1, J2.1, J3.1, J4.1, J5.1, U1.17 (OUT_2), U1.18 (OUT_3), U1.19 (OUT_4), U1.20 (OUT_5), U1.21 (OUT_6), U1.22 (OUT_7), U1.23 (OUT_8), U1.24 (OUT)
+BATT: J1.1, R3.1, R4.1, U1.1 (IN_2), U1.2 (IN_3), U1.3 (IN_4), U1.16 (IN_5), U1.25 (IN)
GND: C1.2, C2.2, C3.2, C4.2, C5.2, D1.1 (K), J1.2, J2.2, J3.2, J4.2, J5.2, R1.2, R2.2, R5.2, U1.4 (GND_2), U1.5 (GND_3), U1.14 (GND_4)
unnamed: D1.2 (A), R6.2
unnamed: C3.1, U1.15 (DV/DT_BGATE)
unnamed: R2.1, R3.2, U1.6 (EN/UVLO)
unnamed: R1.1, U1.8 (ILIM)
unnamed: C5.1, U1.7 (ITIMER)
unnamed: C1.1, U1.11 (NRETRY)
unnamed: R4.2, R5.1, U1.12 (OVLO)
unnamed: R6.1, U1.13 (PG)
unnamed: C2.1, U1.10 (RETRY_DLY)
