Spadeyache/RoboCupJunior_RescueLine/Electronics/Electronics.kicad_pcb

## KiCad design Electronics/archiveKicad/Electronics.kicad_pcb (2025-08-30, an earlier design)

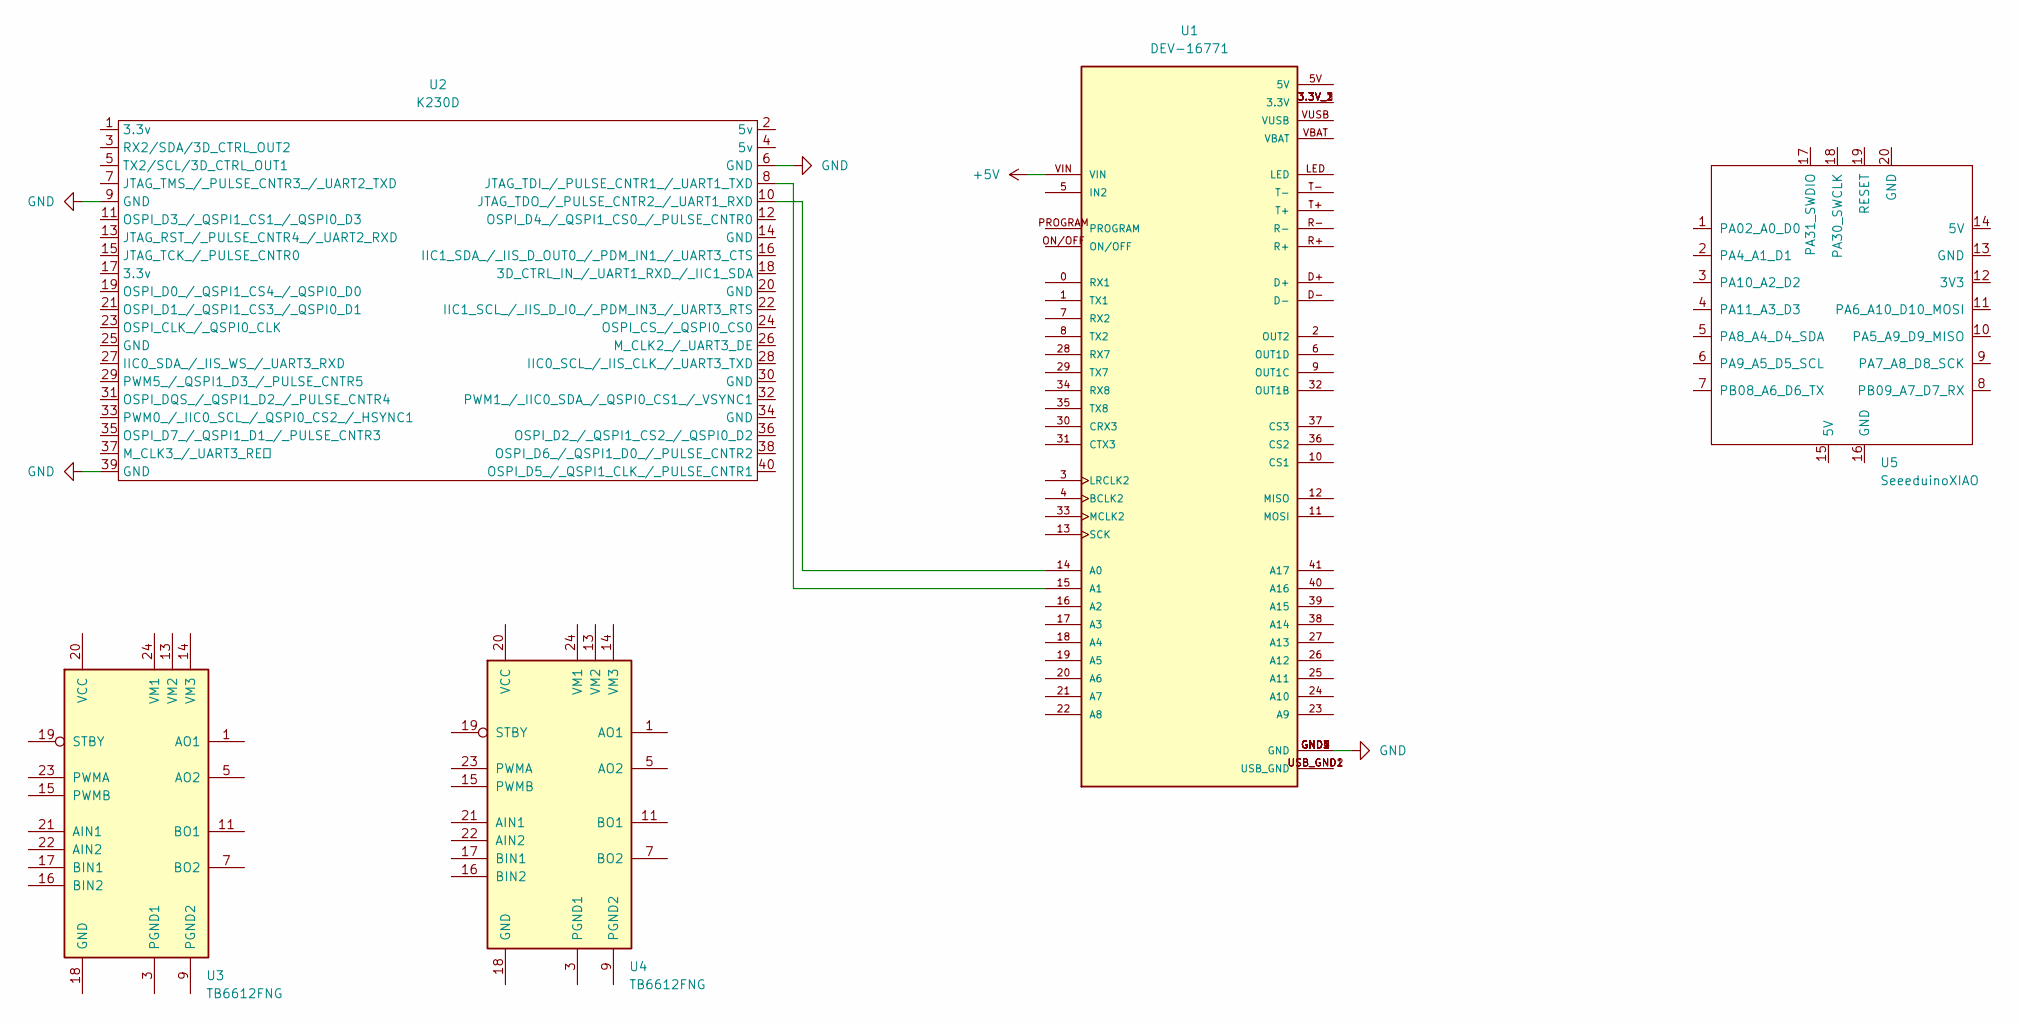
[picture p12: schematic Electronics.kicad_sch]

Parts:
U1: DEV-16771; MODULE_DEV-16771; PARTREV 4.1
U2: K230D; PinSocket_2x20_P2.54mm_Vertical_SMD
U3, U4: TB6612FNG; SSOP-24_5.3x8.2mm_P0.65mm
U5: SeeeduinoXIAO; MCU_Seeed_ESP32C3

Connections:
+5V: U1.VIN
GND: U1.GND1 (GND), U1.GND2 (GND), U1.GND3 (GND), U1.GND4 (GND), U1.GND5 (GND), U2.6 (GND), U2.9 (GND), U2.39 (GND)
unnamed: U1.3.3V_1 (3.3V), U1.3.3V_2 (3.3V), U1.3.3V_3 (3.3V)
unnamed: U1.14 (A0), U2.10 (JTAG_TDO_/_PULSE_CNTR2_/_UART1_RXD)
unnamed: U1.15 (A1), U2.8 (JTAG_TDI_/_PULSE_CNTR1_/_UART1_TXD)
unnamed: U1.USB_GND1 (USB_GND), U1.USB_GND2 (USB_GND)
unnamed: U3.1 (AO1), U3.2 (AO1)
unnamed: U3.5 (AO2), U3.6 (AO2)
unnamed: U3.11 (BO1), U3.12 (BO1)
unnamed: U3.7 (BO2), U3.8 (BO2)
unnamed: U3.3 (PGND1), U3.4 (PGND1)
unnamed: U3.9 (PGND2), U3.10 (PGND2)
unnamed: U4.1 (AO1), U4.2 (AO1)
unnamed: U4.5 (AO2), U4.6 (AO2)
unnamed: U4.11 (BO1), U4.12 (BO1)
unnamed: U4.7 (BO2), U4.8 (BO2)
unnamed: U4.3 (PGND1), U4.4 (PGND1)
unnamed: U4.9 (PGND2), U4.10 (PGND2)

Board: 2 copper layers, 5 parts (0 on the bottom side), 17 nets, no tracks yet.
