Spadeyache/RoboCupJunior_RescueLine/teensy4.1/STS-imuMerge/config.h

#pragma once

// =============================================================================
//  config.h â€” Tune everything from here
// =============================================================================

// --- Hardware Pins ---
#define BUZZER_PIN          37
#define HS45HB0_PIN         3      // arm servo A
#define HS45HB1_PIN         4      // arm servo B
#define PIN_74HCT126_EN     2      // Direction pin for KRS half-duplex serial

// --- Serial Baud Rates ---
#define XIAO_BAUD           4000000UL
#define KRS_BAUD            115200UL
#define KRS_TIMEOUT         400      // ms
#define KRS_ID              1

// --- Motor Speed Limits ---
#define MAX_MOTOR_SPEED     100      // Absolute cap applied to all wheel commands

// --- Line-follow PID (Teensy-side) ---
// Error is derived from xiaoLineError (0â€“254, centre = 127), scaled to Â±200
#define PID_KP              4.5f     // Proportional gain
#define PID_KI              0.0f     // Integral gain
#define PID_KD              3.0f     // Derivative gain
#define PID_BASE_SPEED      100.0f   // Straight-ahead wheel speed
#define PID_LEFT_SCALE      1.7f     // Extra gain on left motor (compensates camera lighting bias)
#define PID_INTEGRAL_LIMIT  500.0f   // Anti-windup clamp on the I-term accumulator

// --- IMU Pitch Compensation ---
// Speed added per degree of forward pitch.  Set to 0 to disable.
#define IMU_SAMPLE_RATE     200.0f   // Hz for Madgwick filter
#define IMU_PITCH_GAIN      0.0f

// --- Turn Motor Speeds ---
#define TURN_UTURN_L       -70.0f
#define TURN_UTURN_R        70.0f
#define TURN_LEFT_L        -70.0f
#define TURN_LEFT_R        100.0f
#define TURN_RIGHT_L       100.0f
#define TURN_RIGHT_R       -70.0f

// --- Turn Durations (ms) ---
#define TURN_UTURN_MS       3200
#define TURN_MS_PER_DEG        11.2

// --- execForward distance calibration ---
// At MAX_MOTOR_SPEED the robot travels ~1 mm every FORWARD_MS_PER_MM ms.
// Measure: drive at speed 100 for 1000 ms, measure distance in mm, then
// set FORWARD_MS_PER_MM = 1000 / distance_mm.
#define FORWARD_MS_PER_MM   7.7f    // ms per mm at MAX_MOTOR_SPEED     calibrate!
#define FORWARD_YAW_KP      1.5f    // P gain for IMU yaw-hold straight driving

// --- Green marker cooldown ---
// After a left/right turn fires, green commands are ignored for this long.
// Prevents re-triggering the same intersection if the motion was too short.
#define DISABLE_GREEN_MS    2000     // ms -- tune to be longer than your turn duration

// --- CommandFilter ---
#define FILTER_QUEUE_SIZE   15       // Rolling window length
#define FILTER_THRESHOLD    9        // Votes needed to confirm a command
#define FILTER_THRESHOLD_RED 5
#define FILTER_THRESHOLD_SILVER 4

// --- Evacuation Zone ---
// #define EVAC_BEEP_ON_MS     20       // Buzzer on-time per beep
// #define EVAC_BEEP_PERIOD_MS 500      // Time between beep starts
