Spadeyache/RoboCupJunior_RescueLine/xiaoesp32/XIAOdev/wifi_config.h

#ifndef WIFI_CONFIG_H
#define WIFI_CONFIG_H

#include <WiFi.h>

// WiFi configuration
#define WIFI_SSID         "Spadeyache32"
#define WIFI_PASSWORD     "pkxc9kvozip2"

#define WIFI_TIMEOUT_MS   10000

// Function declaration
bool WiFi_Init();

#endif // WIFI_CONFIG_H
