Spadeyache/RoboCupJunior_RescueLine/(commit log)

2025-08-30 Fix gitignore: untrack and properly ignore KiCad cache files
2025-10-29 Add files via upload
    New battery files
    [Battery Management.kicad_pcb, Battery Management.kicad_sch]
2025-10-30 Add files via upload
    Main
    [Main.kicad_pcb, Main.kicad_sch]
2025-10-31 Add files via upload
    Done, forgive the trace lengths or I die
    [Main.kicad_pcb, Main.kicad_sch]
2025-11-06 Add files via upload
    I uploaded wrong versions I just saw
    [Main.kicad_pcb, Main.kicad_sch]
2025-12-22 Add files via upload
    Please help make smaller!
    [Main.kicad_pcb, Main.kicad_sch]
2025-12-26 Add files via upload
    Power set contains motor connections and rectifiers. Logic set is the rest.
    [Logic_Set.kicad_pcb, Logic_Set.kicad_sch, Power_Set.kicad_pcb, Power_Set.kicad_sch]
2025-12-26 folder organnized
    [Batter Management v3.kicad_sch, Battery Management.kicad_pcb, Battery Management.kicad_sch, Electronic_Inventory.xlsx, Main (2).kicad_pcb, Main (2).kicad_sch, Main.kicad_pcb, Main.kicad_sch]
2026-01-06 Add files via upload
    Bro ong EasyEda did not let me download the activation file!
    [Faten.kicad_sch, Robotics.kicad_sch]
2026-01-06 powermanagmen merged all circuit
    [powermanagmen.kicad_sch]
2026-01-07 kicad update
    [powermanagmen.eprj, powermanagmen.kicad_sch]
2026-01-10 overwrite to match local
    [Batter Management v3.kicad_sch, Battery Management.kicad_pcb, Battery Management.kicad_sch, Electronic_Inventory.xlsx, Electronics.kicad_pcb, Electronics.kicad_sch, Faten.kicad_sch, Final Main.eprj]
2026-01-10 created dev folders for each board
2026-01-24 imu code
2026-01-24 xiao board update
    [Final Main.eprj, ProPrj_Final Main_2026-01-12.epro, XIAO Board.eprj, XIAO ESP32C3 Adapter board copy.eprj]
2026-01-28 updated pcb
    [Main.eprj]
2026-01-29 teensy pcb design
    [Main.eprj, XIAO ESP32C3 Adapter board copy.eprj]
2026-01-29 k230&pow schema update
    [Main.eprj]
2026-01-30 k230 board design
    [Main.eprj]
2026-01-31 power and k230 fix
    [Main.eprj]
2026-01-31 pow done
    [Main.eprj]
2026-01-31 logo k230
    [Main.eprj]
2026-02-02 Add files via upload
    Updated
    [Main.eprj, XIAO ESP32C3 Adapter board copy.eprj]
2026-02-25 imubaseSTScontroll and printQUAT was added to yacheMPU
2026-02-26 teensydev sts and mpu code optimization
2026-02-27 further optimization of sts and imu controll
2026-03-01 binary read teensycode
2026-03-08 Electronocs Teensy and power pcb update
    [Main.eprj, Main2.eprj]
2026-03-15 xiao ccamera libraries
    [partitions.csv]
2026-03-16 serial camera image
2026-03-17 grayscale is done. hsv convertion without wbmodel calibratio with wb model calibration and optimization for running in main code it to be implemented
2026-03-17 clean up xiao printRawGrayHSV
2026-03-18 xiao clean up, calibration
2026-03-18 everything but calibration is tested
2026-03-18 xiao camera and uart
2026-03-18 pid update
2026-03-18 add line edge case identification
2026-03-19 tested XIAO : PID and color detec color detection logic working
2026-03-21 teensy update
2026-03-29 update 3-29
    [partitions.csv]
2026-03-29 Apply .gitignore changes
    [partitions.csv]
2026-03-29 files renamed in Electronics
    [Main2.eprj]
2026-04-04 pid verified
2026-04-06 2 sensor pid
2026-04-06 PID with center of mass
2026-04-07 reactive pid
2026-04-10 new camera tested
2026-04-13 xiao and teensy working tgt
2026-04-17 xiao pid improvment
2026-04-17 xiao camera FOV changed and upbers adjusted - exeptional preformance
2026-04-17 row30 PID flawless
